AidanHockey5/ESP8266_VGM_Player/(commit log)

2017-07-06 Init with basic player. Still has some minor timing issues related to delay sample rates.
    [ESP8266_VGM_Player.ino]
2017-07-06 Fixed and optimised 0x61 waiting. Computes real sample wait time and only divides when needed. Songs are now very accurate with only a few minor slow downs. Some songs still exhibit odd sound artifac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
    [ESP8266_VGM_Player.ino]
2017-07-14 SN byte-write delay was WAY too high. This should fix the slow-downs in more complex songs.
    [ESP8266_VGM_Player.ino]
